dorukyksl/three-phase-scr-motor-control/media/lab-demo-poster.jpg

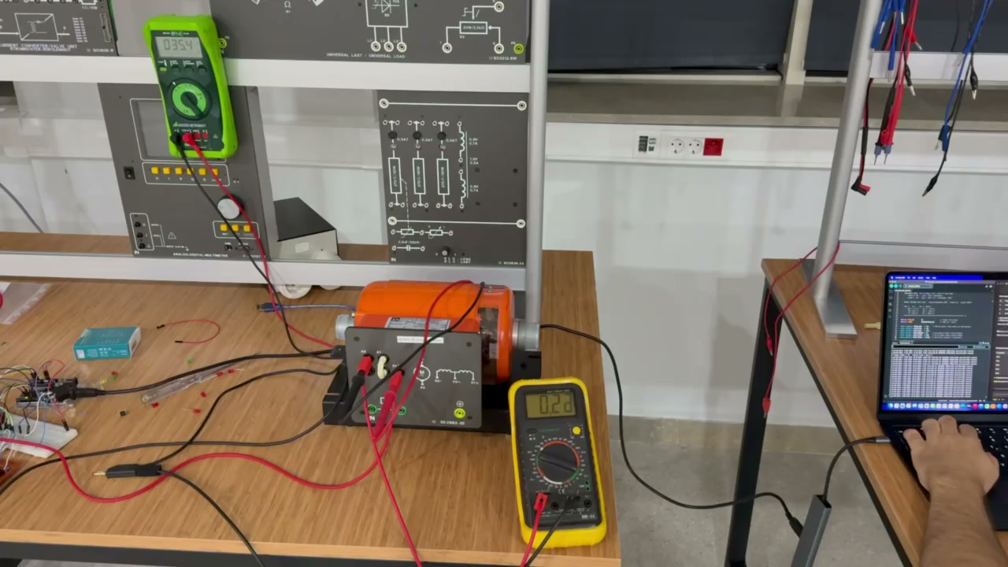
media/lab-demo-poster.jpg
