dorukyksl/three-phase-scr-motor-control/hardware/archive-2026-07-29/bom-utf8.csv

No. | Quantity | Comment | Designator | Footprint | Value | Manufacturer Part | Manufacturer | Supplier Part | Supplier
1 | 1 | 100nF | C1 | CAP-TH_L4.2-W3.8-P5.08-D0.5 | 100nF | 05B104K500PF3C1N0R | STE(松田) | C409821 | LCSC
2 | 1 | 10uF | C2 | CAP-TH_BD4.0-P1.50-D0.8-FD | 10uF | KF106M025C05RR0VH2FP0 | Chengx(承兴) | C43846 | LCSC
3 | 6 | 100nF | C3,C4,C5,C6,C7,C8 | CAP-TH_L17.5-W10.0-P15.00-D1.2 | 100nF | C822J104J60C000 | faratronic(厦门法拉) | C280299 | LCSC
4 | 1 | DB910-7.62-2P-GN-S | CN1 | CONN-TH_2P-P7.62_DB910-7.62-2P |  | DB910-7.62-2P-GN-S | DORABO(地博电气) | C395876 | LCSC
5 | 6 | BT151-500R,127 | D1,D2,D3,D4,D5,D6 | TO-220-3_L10.0-W4.5-P2.54-L |  | BT151-500R,127 | WeEn(瑞能) | C9211 | LCSC
6 | 1 | 1N5408 | D7 | DO-201AD_BD5.3-L8.4-P12.50-D1.4-RD |  | 1N5408 | YANGJIE(扬杰) | C698639 | LCSC
7 | 3 | FUSE | F1,F2,F3 | FUSE_CONN-TH_4628 |  | 4628 | KEYSTONE ELECTRONICS | C3205254 | LCSC
8 | 1 | 2.54-1*3P针 | H1 | HDR-TH_3P-P2.54-V-M-1 |  | 2.54-1*3P针 | BOOMELE(博穆精密) | C49257 | LCSC
9 | 1 | 2.54-1*2P母 | P1 | HDR-TH_2P-P2.54-V-F |  | 2.54-1*2P母 | BOOMELE(博穆精密) | C49661 | LCSC
10 | 6 | 2.2kΩ | R1,R3,R5,R7,R8,R9 | RES-TH_BD5.0-L15.5-P19.50-D0.8 | 2.2kΩ | MF2WS-2K2±1%-9T73 | VO(翔胜) | C479347 | LCSC
11 | 6 | 1kΩ | R2,R4,R6,R10,R11,R12 | RES-TH_BD2.4-L6.3-P10.30-D0.6 | 1kΩ | CFR-25JB-52-1K | YAGEO(国巨) | C1519256 | LCSC
12 | 3 | 15kΩ | R13,R14,R15 | RES-TH_BD4.0-L11.5-P15.50-D0.7 | 15kΩ | MFR2WSJT-73-15K | YAGEO(国巨) | C176557 | LCSC
13 | 3 | 10kΩ | R16,R17,R18 | RES-TH_BD2.2-L6.5-P10.50-D0.6 | 10kΩ | MFR50SFTE52-10K | YAGEO(国巨) | C173139 | LCSC
14 | 6 | 120Ω | R19,R20,R21,R22,R23,R24 | RES-TH_BD2.4-L6.3-P10.30-D0.6 | 120Ω | MFR50SFTE52-120R | YAGEO(国巨) | C173141 | LCSC
15 | 1 | DB910-7.62-4P-GN-S | U1 | CONN-TH_4P-P7.62_DB910-7.62-4P-GN-S |  | DB910-7.62-4P-GN-S | DORABO(地博电气) | C430614 | LCSC
16 | 6 | MOC3023M | U2,U3,U4,U5,U6,U7 | DIP-6_L8.8-W6.4-P2.54-LS7.6-BL |  | MOC3023M | onsemi(安森美) | C5240 | LCSC
17 | 1 | ULN2003AN | U8 | DIP-16_16P-L20.2-W6.6-P2.54-LS7.6-BL |  | ULN2003AN | TI(德州仪器) | C90448 | LCSC
18 | 6 | 330Ω | U9,U10,U11,U12,U15,U16 | RES-TH_BD2.4-L6.3-P10.30-D0.6 | 330Ω | CFR-25JB-52-330R | YAGEO(国巨) | C2935230 | LCSC
19 | 1 | DS1021-1x8SF11-B | U13 | HDR-TH_8P-P2.54-V-M-2 |  | DS1021-1x8SF11-B | CONNFLY | C7430364 | LCSC
20 | 1 | LTV-844 | U14 | DIP-16_16P-L20.2-W6.6-P2.54-LS7.6-BL |  | LTV-844 | LITEON(光宝) | C10789 | LCSC
