dorukyksl/three-phase-scr-motor-control/hardware/archive-2026-07-29/SCH_Ana_Devre_2026-07-29.pdf

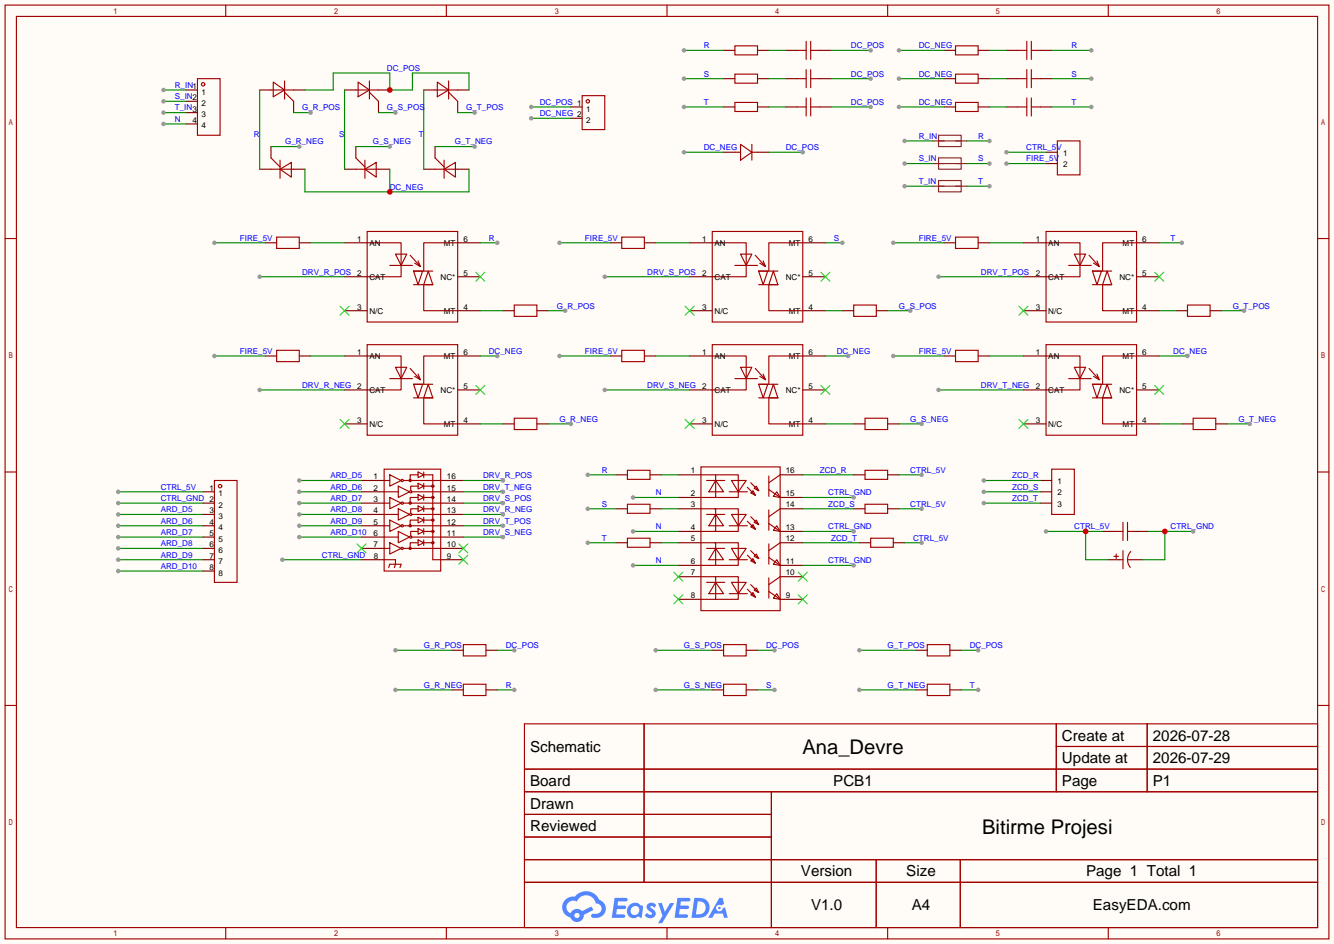
[picture p9: page 1]

Schematic | Ana_Devre | Create at | 2026-07-28

Update at | 2026-07-29

Board | PCB1 | Page | P1
Drawn | | Bitirme Projesi
Reviewed

Version | Size | Page 1 Total 1
V1.0 | A4 | EasyEDA.com
